juchong/NES-PSU-Replacement/README.md

# NES-PSU-Replacement
A replacement NES PSU board that implements a modern switching regulator.
