juchong/NES-PSU-Replacement/design_docs/lmr14050_calcs.xlsx

 | Vin | 7 | V
 | Vout | 5 | V
 | Vin_max | 36 | V
 | Iout | 5 | A
 | Kind | 0.4
 | Fsw | 1100 | khz
 | Overshoot | 1 | %
 | Rt | 21.58 | kohm
 | DeltaiL | 2
 | Lmin | 0.001957070707 | H | 1.96 | uH
 | Vout_esr = Vout_c | 0.05 | V
11 | ESR | 0.025 | mohm
12 | Vout_c | 0.0045 | mF | 4.55 | uF
 | Vus=Vos | 0.05 | V
13 | Cout> | 0.07438016529 |  | 74.38 | uF | Target C
