juchong/NES-PSU-Replacement/pdfs/NES PSU Replacement BRD.pdf

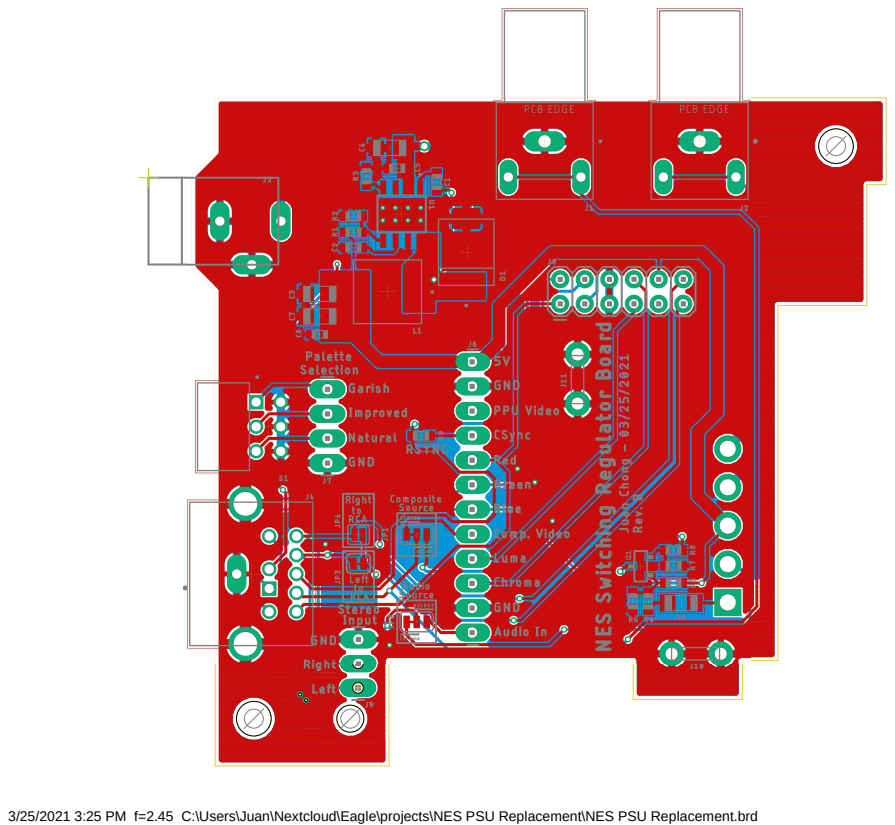
[picture p1: page 1]

3/25/2021 3:25 PM f=2.45 C:\Users\Juan\Nextcloud\Eagle\projects\NES PSU Replacement\NES PSU Replacement.brd
