juchong/NES-PSU-Replacement/pdfs/NES PSU Replacement SCH.pdf

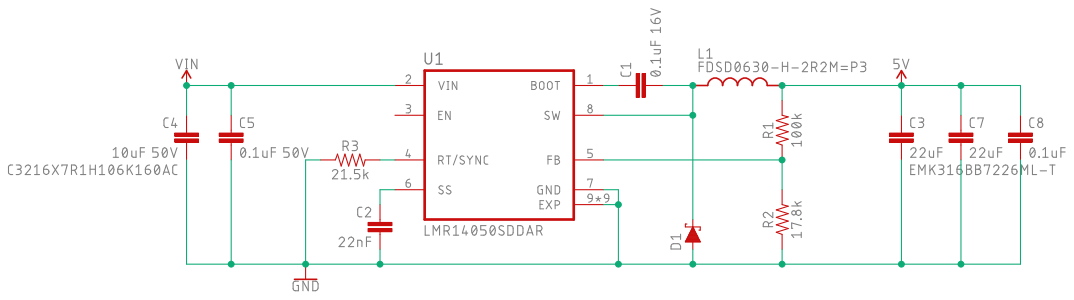
[picture p2: page 1]

3/25/2021 3:25 PM f=0.93 C:\Users\Juan\Nextcloud\Eagle\projects\NES PSU Replacement\NES PSU Replacement.sch (Sheet: 1/2)

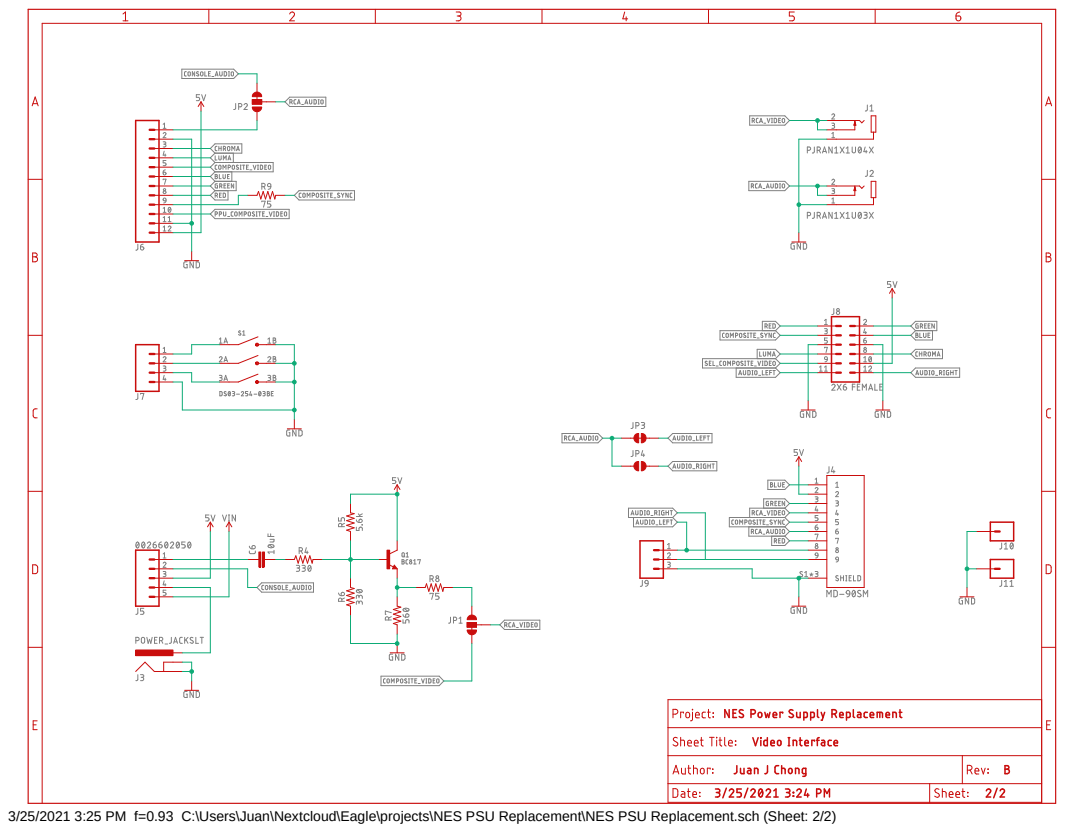
[picture p3: page 2]

3/25/2021 3:25 PM f=0.93 C:\Users\Juan\Nextcloud\Eagle\projects\NES PSU Replacement\NES PSU Replacement.sch (Sheet: 2/2)
