juchong/NES-PSU-Replacement/eagle/NES PSU Replacement.brd

## EAGLE design eagle/NES PSU Replacement.brd (2021-03-25)

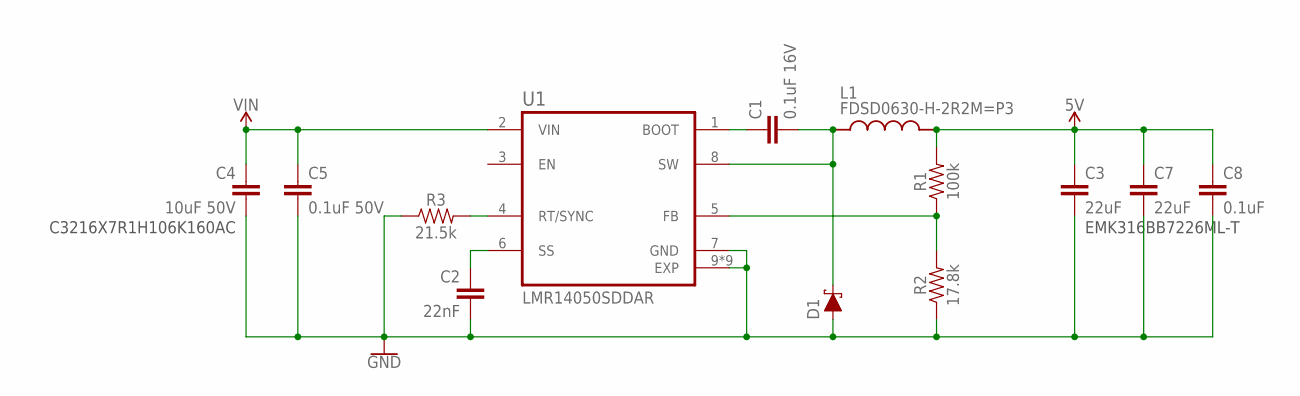
[picture p4: schematic NES PSU Replacement.sch, sheet 1, Switching Power Supply]

Parts:
C1: 0.1uF 16V; 0603
C2: 22nF; 0603
C3, C7: 22uF; 1206
C4: 10uF 50V; 1206
C5: 0.1uF 50V; 0603
C8: 0.1uF; 0603
D1: 1A/15V/220mV; DO-214AB
L1: FDSD0630-H-2R2M=P3; IND_FDSD0630-H-2R2M=P3
R1: 100k; 0603
R2: 17.8k; 0603
R3: 21.5k; 0603
U1: LMR14050SDDAR; VREG_LM5017MR/NOPB

Connections:
5V: C3.1, C7.1, C8.1, L1.2, R1.2; also elsewhere on the board
GND: C2.2, C3.2, C4.2, C5.2, C7.2, C8.2, D1.2 (A), R2.1, R3.1, U1.7 (GND), U1.9 (EXP), U1.10 (EXP), U1.11 (EXP), U1.12 (EXP), U1.13 (EXP), U1.14 (EXP), U1.15 (EXP), U1.16 (EXP), U1.17 (EXP); also elsewhere on the board
unnamed: R1.1, R2.2, U1.5 (FB)
unnamed: R3.2, U1.4 (RT/SYNC)
unnamed: C2.1, U1.6 (SS)
unnamed: C1.2, D1.1 (C), L1.1, U1.8 (SW)
unnamed: C1.1, U1.1 (BOOT)
VIN: C4.1, C5.1, U1.2 (VIN); also elsewhere on the board

Notes on the sheet:
EMK316BB7226ML-T
C3216X7R1H106K160AC

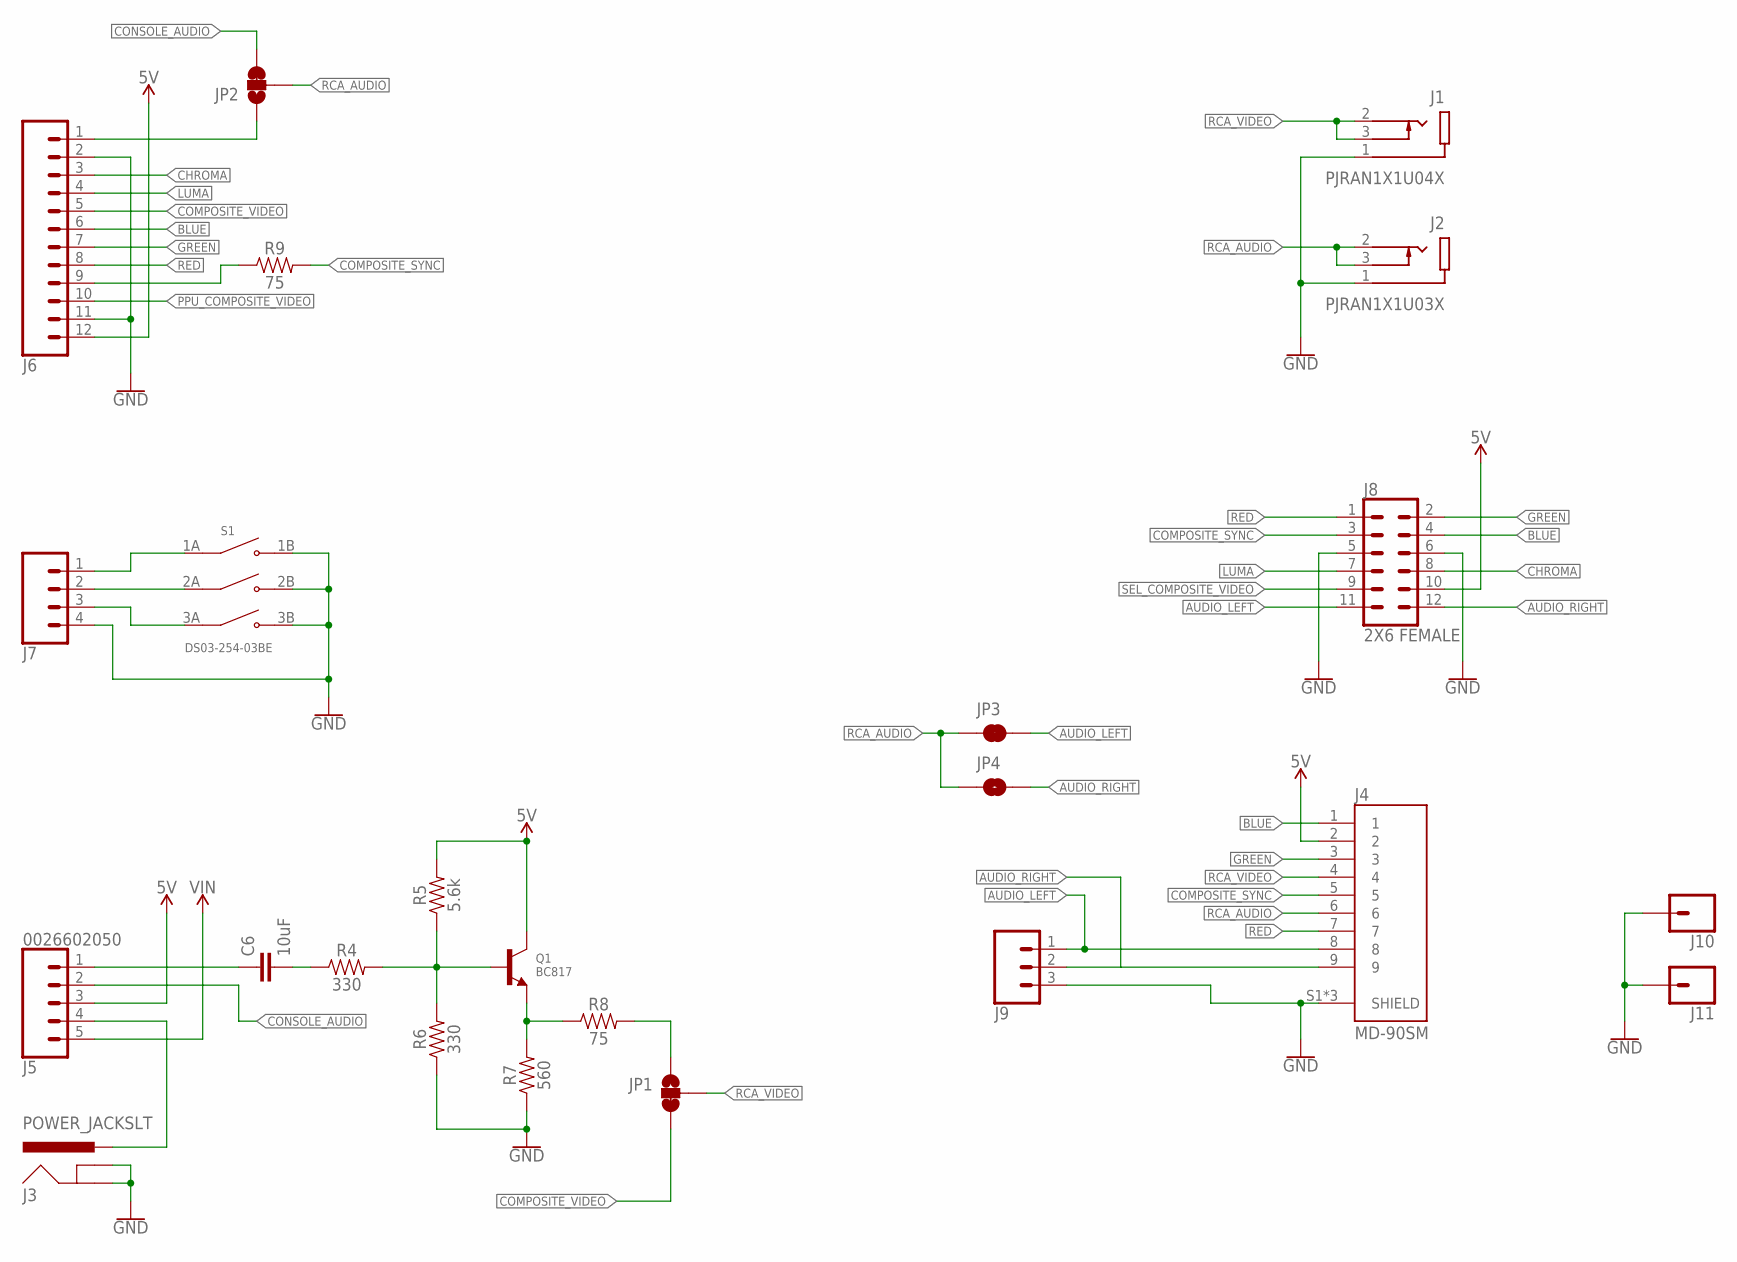
[picture p5: schematic NES PSU Replacement.sch, sheet 2, Video Interface]

Parts:
C6: 10uF; 1206
J1: PJRAN1X1U04X; SWITCHCRAFT_PJRAN1X1U02AUX
J2: PJRAN1X1U03X; SWITCHCRAFT_PJRAN1X1U02AUX
J3: POWER_JACKSLT; POWER_JACK_SLOT
J4: MD-90SM; CUI_MD-90SM
J5: 0026602050; 1X05_3.96MM
J6: CONN_12LONGPADS; 1X12_LONGPADS
J7: CONN_04LONGPADS; 1X04_LONGPADS
J8: 2X6 FEMALE; 2X6
J9: CONN_03LONGPADS; 1X03_LONGPADS
J10, J11: CONN_01KEYSTONE_1216; 1X01_1216
JP1, JP2: JUMPER-SMT_3_1-NC_TRACE_SILK; SMT-JUMPER_3_1-NC_TRACE_SILK
JP3: JUMPER-SMT_2_NC_TRACE_SILK; SMT-JUMPER_2_NC_TRACE_SILK
JP4: JUMPER-SMT_2_NO_SILK; SMT-JUMPER_2_NO_SILK
Q1: BC817; SOT23-R
R4, R6: 330; 0603
R5: 5.6k; 0603
R7: 560; 0603
R8, R9: 75; 0603
S1: DS03-254-03BE; SW_DS03-254-03BE

Connections:
5V: J4.2, J5.3, J6.12, J8.10, Q1.3 (C), R5.2; also elsewhere on the board
AUDIO_LEFT: J4.8, J8.11, J9.1, JP3.2
AUDIO_RIGHT: J4.9, J8.12, J9.2, JP4.2
BLUE: J4.1, J6.6, J8.4
CHROMA: J6.3, J8.8
COMPOSITE_SYNC: J4.5, J8.3, R9.2
COMPOSITE_VIDEO: J6.5, JP1.3
CONSOLE_AUDIO: J5.2, JP2.3
GND: J1.1 (SLEEVE), J2.1 (SLEEVE), J3.GND@1 (GNDBREAK), J3.GND@2 (GND), J4.S1 (SHIELD), J4.S2 (SHIELD), J4.S3 (SHIELD), J6.2, J6.11, J7.4, J8.5, J8.6, J9.3, J10.P$1, J10.P$2, J11.P$1, J11.P$2, R6.1, R7.1, S1.1B (NO1), S1.2B (NO2), S1.3B (NO3); also elsewhere on the board
GREEN: J4.3, J6.7, J8.2
LUMA: J6.4, J8.7
unnamed: J7.1, S1.1A (COM1)
unnamed: J7.2, S1.2A (COM2)
unnamed: J7.3, S1.3A (COM3)
unnamed: Q1.1 (B), R4.2, R5.1, R6.2
unnamed: J3.PWR, J5.4
unnamed: JP1.1, R8.2
unnamed: C6.2, R4.1
unnamed: Q1.2 (E), R7.2, R8.1
unnamed: C6.1, J5.1
unnamed: J6.9, R9.1
unnamed: J6.1, JP2.1
PPU_COMPOSITE_VIDEO: J6.10
RCA_AUDIO: J2.2 (TIP), J2.3 (SHUNT), J4.6, JP2.2, JP3.1, JP4.1
RCA_VIDEO: J1.2 (TIP), J1.3 (SHUNT), J4.4, JP1.2
RED: J4.7, J6.8, J8.1
SEL_COMPOSITE_VIDEO: J8.9
VIN: J5.5; also elsewhere on the board

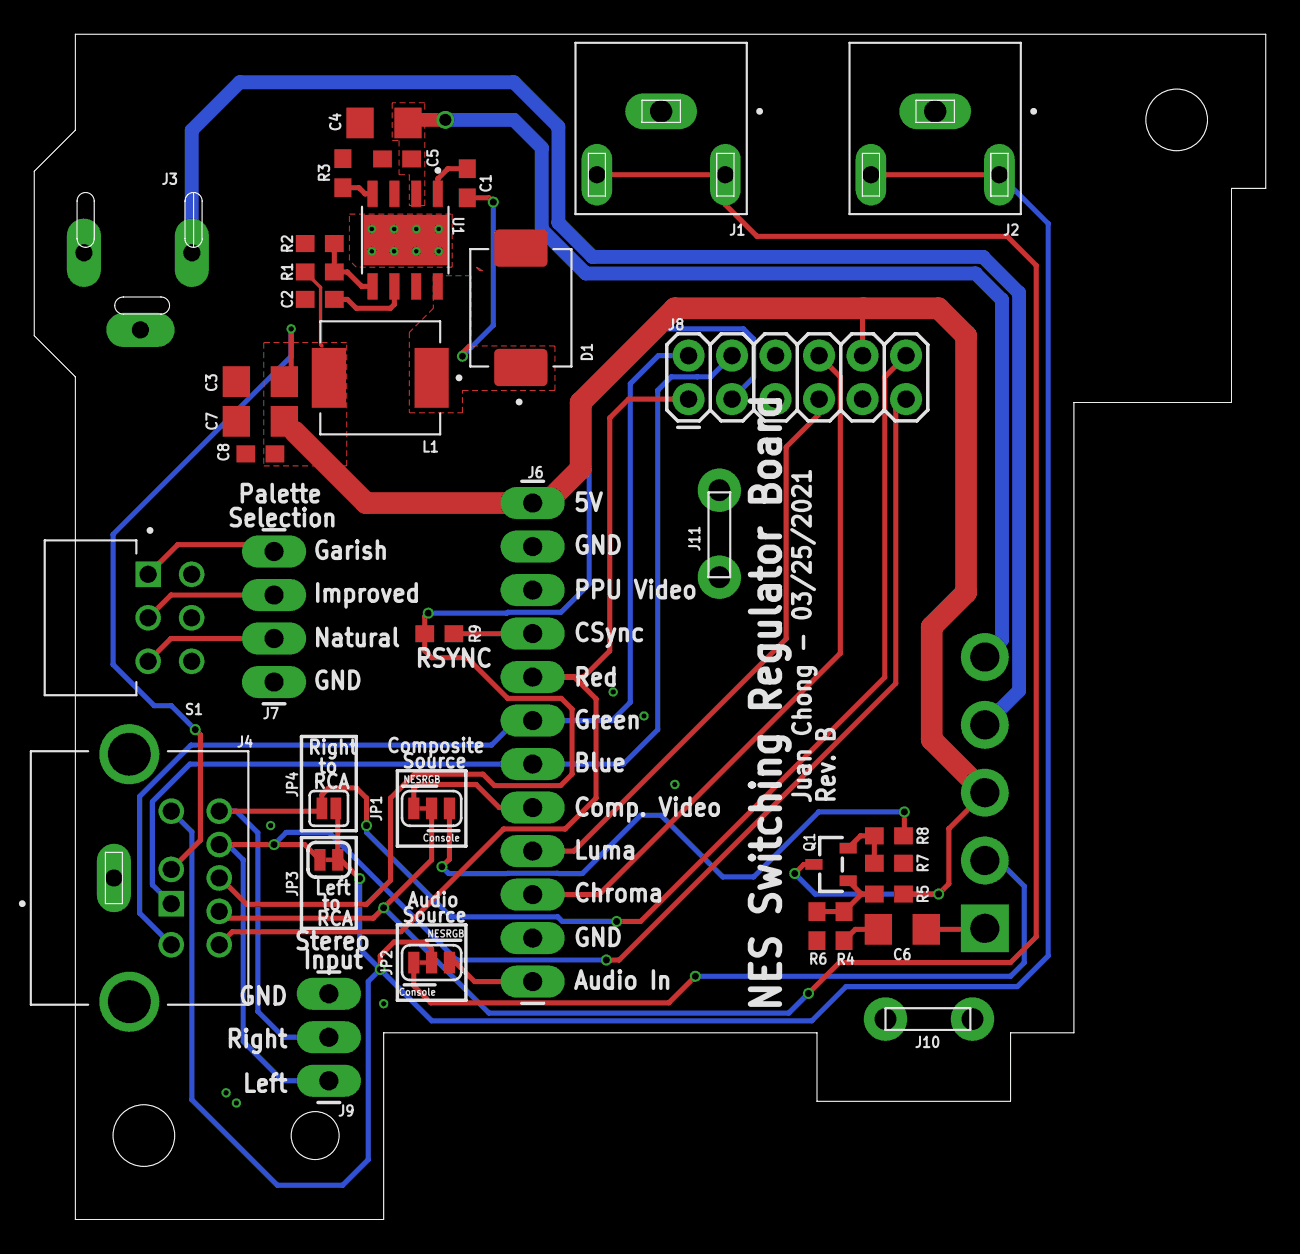
[picture p6: board NES PSU Replacement.brd from above]

Board: 2 copper layers, 71.9 x 69.2 mm, 37 parts (0 on the bottom side), 31 nets.
