juchong/NES-PSU-Replacement/(commit log)

2021-03-25 Initial commit. PCB revisions start at RevB
    [NES PSU Replacement.brd, NES PSU Replacement.sch, lmr14050_calcs.xlsx]
2021-03-25 Moved Eagle files out of the root directory
    [NES PSU Replacement.brd, NES PSU Replacement.sch]
